jean-claudeF/ArbitraryWaveformGenerator/awg_circuit.png

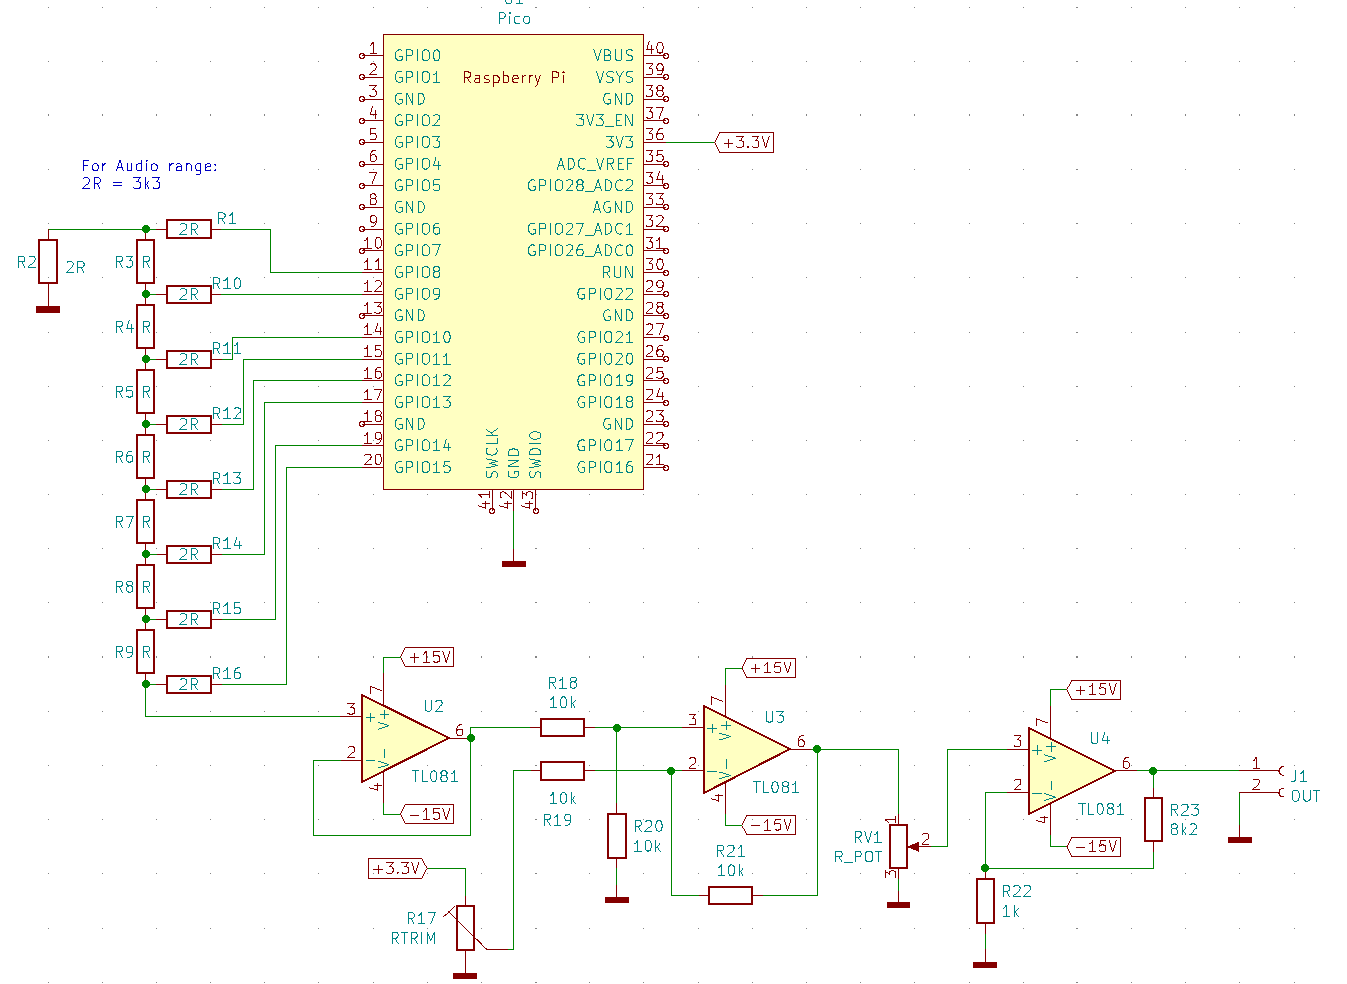
awg_circuit.png
