jean-claudeF/ArbitraryWaveformGenerator/pico_awg.jpeg

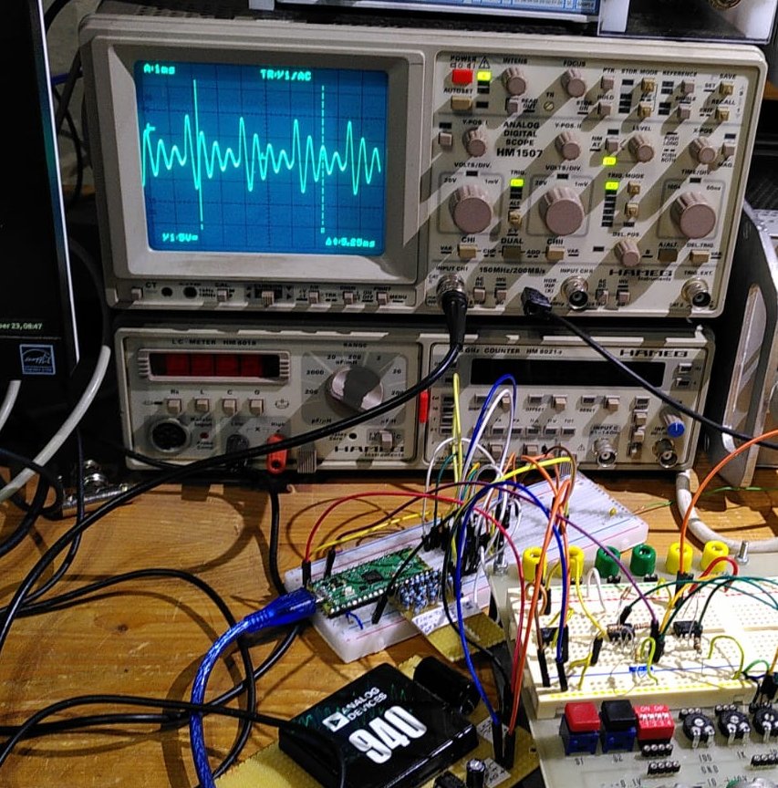
pico_awg.jpeg
