jean-claudeF/ArbitraryWaveformGenerator/tk_awg_04.png

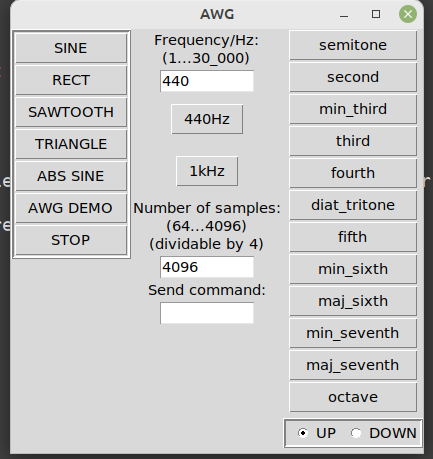
tk_awg_04.png
