jean-claudeF/ArbitraryWaveformGenerator/KICAD/dds_pico_01.sch

## KiCad design KICAD/dds_pico_01.sch (2024-12-26)

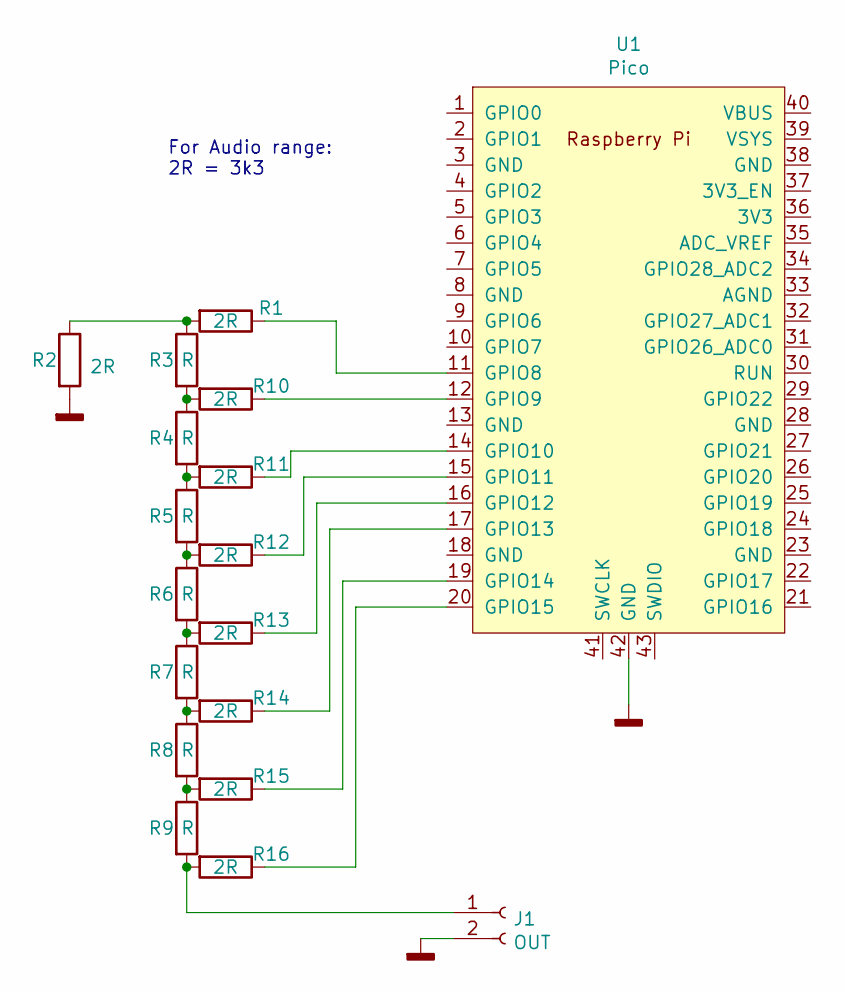
[picture p7: schematic dds_pico_01.sch]

Parts:
J1: OUT
R1, R2, R10, R11, R12, R13, R14, R15, R16: 2R
R3, R4, R5, R6, R7, R8, R9: R
U1: Pico; RPi_Pico_SMD_TH

Connections:
GNDD: J1.2, R2.2, U1.42 (GND)
unnamed: J1.1, R9.2, R16.2
unnamed: R1.1, U1.11 (GPIO8)
unnamed: R1.2, R2.1, R3.1
unnamed: R10.1, U1.12 (GPIO9)
unnamed: R3.2, R4.1, R10.2
unnamed: R11.1, U1.14 (GPIO10)
unnamed: R4.2, R5.1, R11.2
unnamed: R12.1, U1.15 (GPIO11)
unnamed: R5.2, R6.1, R12.2
unnamed: R13.1, U1.16 (GPIO12)
unnamed: R6.2, R7.1, R13.2
unnamed: R14.1, U1.17 (GPIO13)
unnamed: R7.2, R8.1, R14.2
unnamed: R15.1, U1.19 (GPIO14)
unnamed: R8.2, R9.1, R15.2
unnamed: R16.1, U1.20 (GPIO15)

Notes on the sheet:
For Audio range: 2R = 3k3
