jean-claudeF/ArbitraryWaveformGenerator/KICAD/dds_pico_02.sch

## KiCad design KICAD/dds_pico_02.sch (2024-12-26)

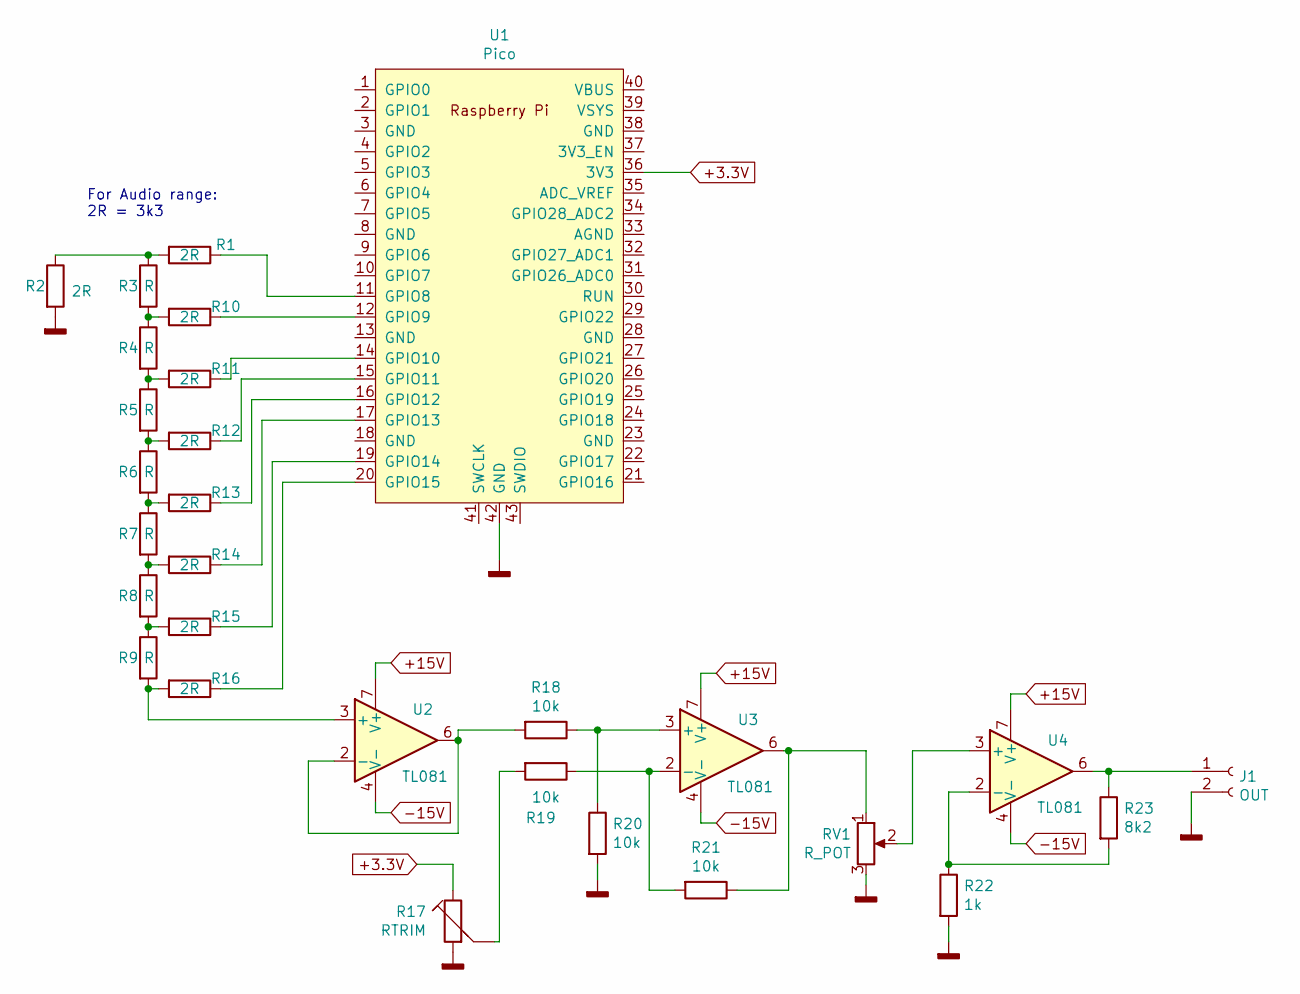
[picture p8: schematic dds_pico_02.sch]

Parts:
J1: OUT
R1, R2, R10, R11, R12, R13, R14, R15, R16: 2R
R3, R4, R5, R6, R7, R8, R9: R
R17: RTRIM
R18, R19, R20, R21: 10k
R22: 1k
R23: 8k2
RV1: R_POT
U1: Pico; RPi_Pico_SMD_TH
U2, U3, U4: TL081

Connections:
+3.3V: R17.1, U1.36 (3V3)
+15V: U2.7 (V+), U3.7 (V+), U4.7 (V+)
-15V: U2.4 (V-), U3.4 (V-), U4.4 (V-)
GNDD: J1.2, R2.2, R17.2, R20.2, R22.2, RV1.3, U1.42 (GND)
unnamed: J1.1, R23.1, U4.6
unnamed: R1.1, U1.11 (GPIO8)
unnamed: R1.2, R2.1, R3.1
unnamed: R10.1, U1.12 (GPIO9)
unnamed: R3.2, R4.1, R10.2
unnamed: R11.1, U1.14 (GPIO10)
unnamed: R4.2, R5.1, R11.2
unnamed: R12.1, U1.15 (GPIO11)
unnamed: R5.2, R6.1, R12.2
unnamed: R13.1, U1.16 (GPIO12)
unnamed: R6.2, R7.1, R13.2
unnamed: R14.1, U1.17 (GPIO13)
unnamed: R7.2, R8.1, R14.2
unnamed: R15.1, U1.19 (GPIO14)
unnamed: R8.2, R9.1, R15.2
unnamed: R16.1, U1.20 (GPIO15)
unnamed: R9.2, R16.2, U2.3 (+)
unnamed: R17.~, R19.2
unnamed: R18.1, R20.1, U3.3 (+)
unnamed: R18.2, U2.2 (-), U2.6
unnamed: R19.1, R21.2, U3.2 (-)
unnamed: R21.1, RV1.1, U3.6
unnamed: R22.1, R23.2, U4.2 (-)
unnamed: RV1.2, U4.3 (+)

Notes on the sheet:
For Audio range: 2R = 3k3
