jean-claudeF/ArbitraryWaveformGenerator/Micropython/awgvalues.py

function = 'sin(2*pi*x) + cos(3*pi*x)'
N = 2048
values = [231, 231, 232, 232, 232, 233, 233, 233, 233, 234, 234, 234, 235, 235, 235, 236, 236, 236, 236, 237, 237, 237, 237, 238, 238, 238, 239, 239, 239, 239, 240, 240, 240, 240, 241, 241, 241, 241, 242, 242, 242, 242, 242, 243, 243, 243, 243, 244, 244, 244, 244, 244, 245, 245, 245, 245, 245, 246, 246, 246, 246, 246, 246, 247, 247, 247, 247, 247, 248, 248, 248, 248, 248, 248, 248, 249, 249, 249, 249, 249, 249, 249, 250, 250, 250, 250, 250, 250, 250, 250, 251, 251, 251, 251, 251, 251, 251, 251, 251, 252, 252, 252, 252, 252, 252, 252, 252, 252, 252, 252, 252, 252, 253, 253, 253, 253, 253, 253, 253, 253, 253, 253, 253, 253, 253, 253, 253, 253, 253, 253, 253, 253, 253, 253, 253, 253, 253, 253, 253, 253, 253, 254, 253, 253, 253, 253, 253, 253, 253, 253, 253, 253, 253, 253, 253, 253, 253, 253, 253, 253, 253, 253, 253, 253, 253, 253, 253, 253, 253, 253, 253, 253, 252, 252, 252, 252, 252, 252, 252, 252, 252, 252, 252, 252, 252, 251, 251, 251, 251, 251, 251, 251, 251, 251, 251, 250, 250, 250, 250, 250, 250, 250, 250, 249, 249, 249, 249, 249, 249, 249, 249, 248, 248, 248, 248, 248, 248, 248, 247, 247, 247, 247, 247, 247, 246, 246, 246, 246, 246, 246, 245, 245, 245, 245, 245, 245, 244, 244, 244, 244, 244, 243, 243, 243, 243, 243, 242, 242, 242, 242, 242, 241, 241, 241, 241, 241, 240, 240, 240, 240, 239, 239, 239, 239, 239, 238, 238, 238, 238, 237, 237, 237, 237, 236, 236, 236, 236, 235, 235, 235, 235, 234, 234, 234, 234, 233, 233, 233, 233, 232, 232, 232, 232, 231, 231, 231, 230, 230, 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
0, 0, 0, 0, 0, 0, 0, 0, 0, 0, 0, 0, 0, 0, 0, 0, 0, 0, 0, 0, 0, 0, 0, 0, 0, 0, 0, 0, 0, 0, 0, 0, 0, 0, 0, 0, 0, 0, 0, 0, 0, 0, 0, 0, 0, 0, 0, 0, 0, 0, 1, 1, 1, 1, 1, 1, 1, 1, 1, 1, 1, 1, 1, 2, 2, 2, 2, 2, 2, 2, 2, 2, 3, 3, 3, 3, 3, 3, 3, 3, 4, 4, 4, 4, 4, 4, 4, 5, 5, 5, 5, 5, 5, 5, 6, 6, 6, 6, 6, 7, 7, 7, 7, 7, 7, 8, 8, 8, 8, 8, 9, 9, 9, 9, 9, 10, 10, 10, 10, 11, 11, 11, 11, 11, 12, 12, 12, 12, 13, 13, 13, 13, 14, 14, 14, 14, 15, 15, 15, 16, 16, 16, 16, 17, 17, 17, 17, 18, 18, 18, 19, 19, 19, 20, 20, 20, 20, 21, 21, 21, 22, 22]
