jean-claudeF/ArbitraryWaveformGenerator/Python/awgvalues.py

N = 1024
values = [199, 200, 200, 201, 202, 203, 204, 205, 206, 207, 207, 208, 209, 210, 211, 212, 212, 213, 214, 215, 216, 216, 217, 218, 219, 220, 220, 221, 222, 223, 223, 224, 225, 226, 226, 227, 228, 228, 229, 230, 231, 231, 232, 233, 233, 234, 234, 235, 236, 236, 237, 237, 238, 239, 239, 240, 240, 241, 241, 242, 242, 243, 243, 244, 244, 245, 245, 246, 246, 246, 247, 247, 248, 248, 248, 249, 249, 249, 250, 250, 250, 250, 251, 251, 251, 251, 252, 252, 252, 252, 252, 253, 253, 253, 253, 253, 253, 253, 253, 253, 253, 253, 253, 254, 253, 253, 253, 253, 253, 253, 253, 253, 253, 253, 253, 253, 252, 252, 252, 252, 252, 252, 251, 251, 251, 251, 250, 250, 250, 249, 249, 249, 248, 248, 248, 247, 247, 246, 246, 245, 245, 244, 244, 243, 243, 242, 242, 241, 241, 240, 240, 239, 238, 238, 237, 237, 236, 235, 235, 234, 233, 232, 232, 231, 230, 229, 229, 228, 227, 226, 225, 225, 224, 223, 222, 221, 220, 219, 219, 218, 217, 216, 215, 214, 213, 212, 211, 210, 209, 208, 207, 206, 205, 204, 203, 202, 201, 200, 199, 197, 196, 195, 194, 193, 192, 191, 190, 188, 187, 186, 185, 184, 183, 181, 180, 179, 178, 177, 175, 174, 173, 172, 170, 169, 168, 167, 165, 164, 163, 162, 160, 159, 158, 156, 155, 154, 153, 151, 150, 149, 147, 146, 145, 143, 142, 141, 139, 138, 137, 135, 134, 133, 131, 130, 129, 127, 126, 125, 124, 122, 121, 120, 118, 117, 116, 114, 113, 112, 110, 109, 108, 106, 105, 104, 102, 101, 100, 98, 97, 96, 95, 93, 92, 91, 90, 88, 87, 86, 84, 83, 82, 81, 79, 78, 77, 76, 75, 73, 72, 71, 70, 69, 67, 6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
